lugovskovp/TrafficLight13/README.txt

docs
	ATmega328 datasheet.pdf
	attinu13piout.jpg
	ATtiny13A datasheet.pdf
	AVR4013 — PicoPower basics.pdf
	AVR4027 - Tips and Tricks to Optimize Your C Code.pdf
	Button state machine.vsd
	led colors and voltages.jpg
	power.xlsx

gcc
	0_MAKE & asm.cmd
	0_MAKE & upload.cmd

pix
	arduino pro mini pinout.png
	attiny13 min setup.png
	Button state machine.jpg
	usbasp pinout.png
	vs scr.png

schematic
	traffic light ver0.dch
	traffic light.dch
	traffic light.dip
	
TrafficLight13
	TrafficLight13.ino
	TrafficLight13.vcxproj
	TrafficLight13.vcxproj.filters
