lugovskovp/TrafficLight13/docs/hypothesis_check.txt

https://habr.com/ru/post/443188/#comment_19872776
Предлагаю эксперимент. В свободное/ближайшее время я в исходник светофора добавлю глобальную переменную. Буду в ней считать что-нибудь, неважно, бесполезное. Количество переключений, или сравнивать с чем то, не суть. Просто новая переменная.
Затем сравню размеры прошивок — где переменная как глобальная, и переменная, та же самая, как локальная. Код выложу на github — чтобы любой мог повторить эксперимент.
Моё мнение — что размеры прошивок будут разными, причем в случае с локальной переменной размер будет меньше.

Вы готовы поддержать противоположную точку зрения, сказать, что по-вашему мнению, размер прошивки не уменьшится?

Всё просто, честно, наглядно.

Журнал эксперимента:

Добавлена бесполезная переменная и её использование в TrafficLight13.ino

1. Глобально
uint16_t useless_var __attribute__ ((section (".noinit")));
int main() {

-O0
Program:    2192 bytes (214.1% Full)
Data:         10 bytes (15.6% Full)

-Os
Program:    1060 bytes (103.5% Full)
Data:         10 bytes (15.6% Full)

2. локально
int main() {
	uint16_t useless_var;
	
-O0
Program:    2146 bytes (209.6% Full)
Data:          8 bytes (12.5% Full)
	
-Os
Program:     982 bytes (95.9% Full)
Data:          8 bytes (12.5% Full)

3. Расчеты и выводы
-O0 разница g-l 2192 - 2146 = 46
-Os разница g-l 1060 - 982 = 78
