lugovskovp/TrafficLight13/pix/Button state machine.jpg

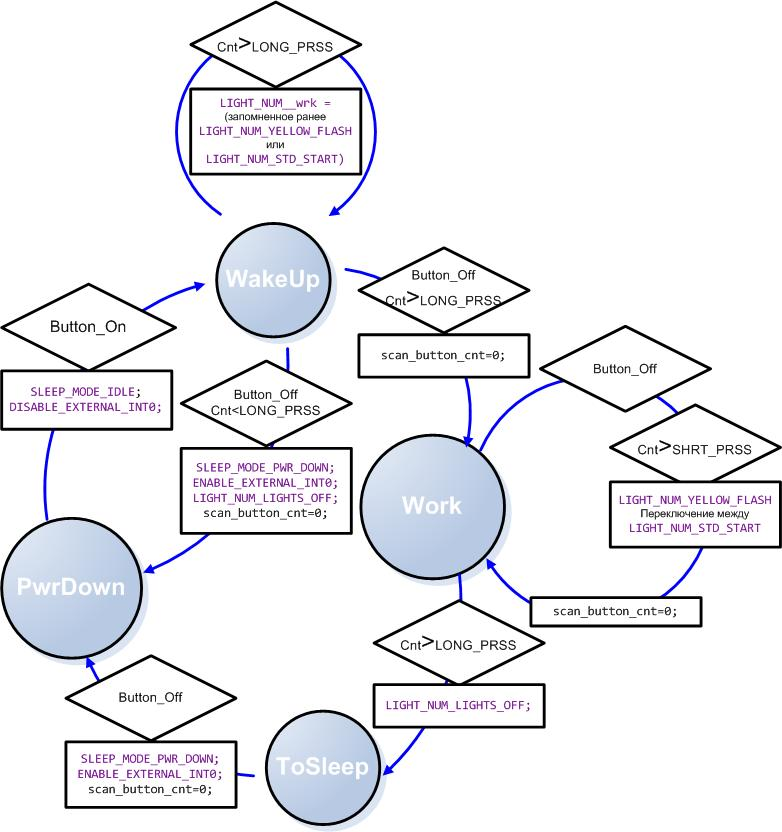
pix/Button state machine.jpg
