lugovskovp/TrafficLight13/pix/led colors and voltages.jpg

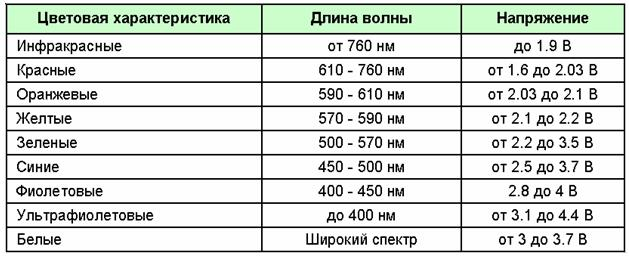
pix/led colors and voltages.jpg
