lugovskovp/TrafficLight13/pix/vs scr.png

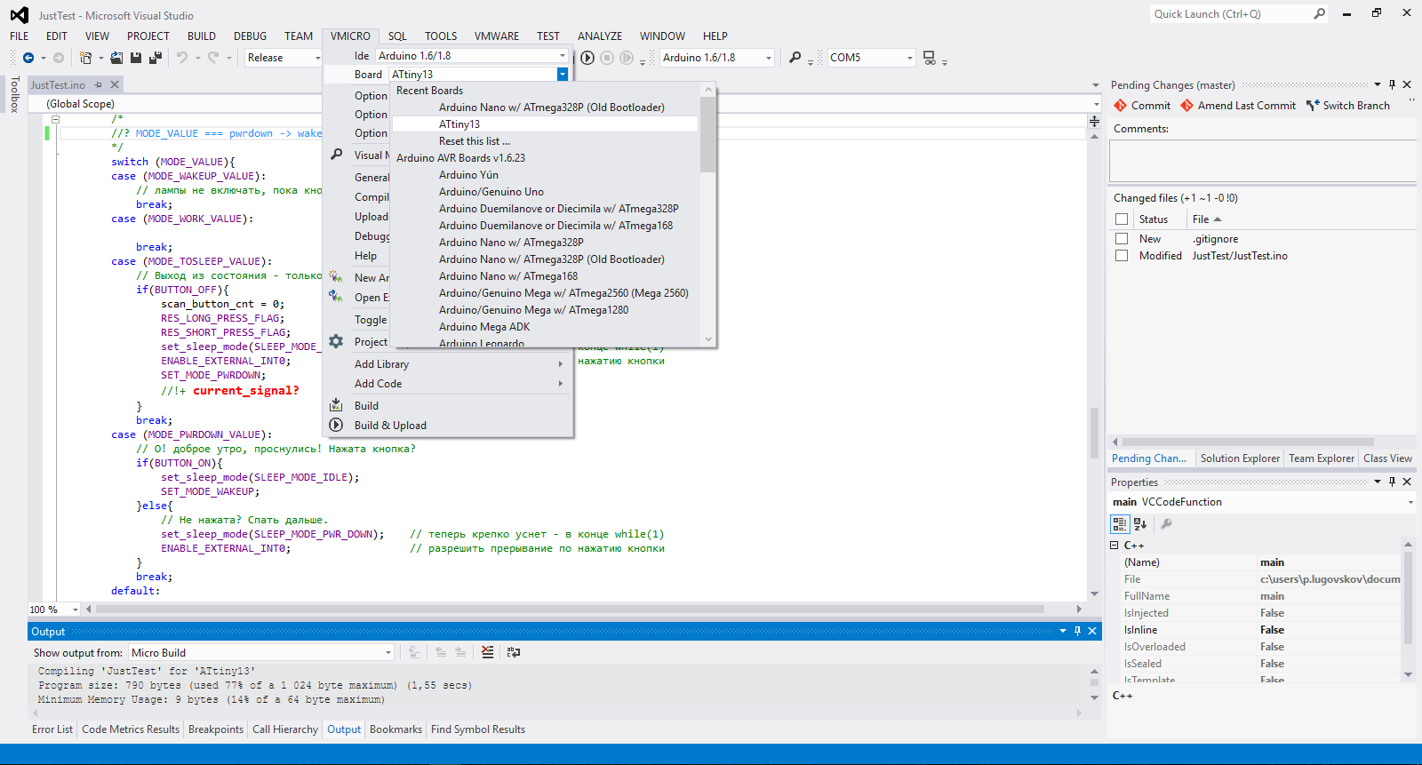
pix/vs scr.png
