lugovskovp/TrafficLight13/(list of files, drawings)

Other design files:
schematic/traffic light ver0.dch
schematic/traffic light ver charlie.dch
schematic/traffic light.dch
schematic/traffic light.dip
