lugovskovp/TrafficLight13/docs/asm/TrafficLight13-Os.asm

./Release/TrafficLight13.elf:     file format elf32-avr


Disassembly of section .text:

00000000 <__vectors>:
   0:	39 c0       	rjmp	.+114    	; 0x74 <__ctors_end>
   2:	5e c0       	rjmp	.+188    	; 0xc0 <__vector_1>
   4:	45 c0       	rjmp	.+138    	; 0x90 <__bad_interrupt>
   6:	45 c0       	rjmp	.+138    	; 0x92 <__vector_3>
   8:	43 c0       	rjmp	.+134    	; 0x90 <__bad_interrupt>
   a:	42 c0       	rjmp	.+132    	; 0x90 <__bad_interrupt>
   c:	41 c0       	rjmp	.+130    	; 0x90 <__bad_interrupt>
   e:	40 c0       	rjmp	.+128    	; 0x90 <__bad_interrupt>
  10:	3f c0       	rjmp	.+126    	; 0x90 <__bad_interrupt>
  12:	3e c0       	rjmp	.+124    	; 0x90 <__bad_interrupt>

00000014 <__trampolines_end>:
  14:	18 08       	sbc	r1, r8
  16:	00 00       	nop
  18:	00 00       	nop
  1a:	b9 00       	.word	0x00b9	; ????
  1c:	08 08       	sbc	r0, r8
  1e:	18 08       	sbc	r1, r8
  20:	09 00       	.word	0x0009	; ????
  22:	6f 00       	.word	0x006f	; ????
  24:	09 09       	sbc	r16, r9
  26:	00 00       	nop
  28:	00 00       	nop
  2a:	25 00       	.word	0x0025	; ????
  2c:	0d 0d       	add	r16, r13
  2e:	00 00       	nop
  30:	00 00       	nop
  32:	4a 00       	.word	0x004a	; ????
  34:	18 10       	cpse	r1, r8
  36:	00 00       	nop
  38:	00 00       	nop
  3a:	03 01       	movw	r0, r6
  3c:	18 10       	cpse	r1, r8
  3e:	08 00       	.word	0x0008	; ????
  40:	09 00       	.word	0x0009	; ????
  42:	6f 00       	.word	0x006f	; ????
  44:	0c 04       	cpc	r0, r12
  46:	00 00       	nop
  48:	00 00       	nop
  4a:	25 00       	.word	0x0025	; ????
  4c:	0d 05       	cpc	r16, r13
  4e:	00 00       	nop
  50:	00 00       	nop
  52:	4a 00       	.word	0x004a	; ????
  54:	05 05       	cpc	r16, r5
  56:	05 00       	.word	0x0005	; ????
  58:	25 00       	.word	0x0025	; ????
	...
  62:	00 00       	nop
  64:	1c 0c       	add	r1, r12
  66:	19 11       	cpse	r17, r9
  68:	01 00       	.word	0x0001	; ????
  6a:	25 00       	.word	0x0025	; ????
  6c:	14 04       	cpc	r1, r4
  6e:	11 11       	cpse	r17, r1
  70:	01 00       	.word	0x0001	; ????
	...

00000074 <__ctors_end>:
  74:	11 24       	eor	r1, r1
  76:	1f be       	out	0x3f, r1	; 63
  78:	cf e9       	ldi	r28, 0x9F	; 159
  7a:	cd bf       	out	0x3d, r28	; 61

0000007c <__do_clear_bss>:
  7c:	20 e0       	ldi	r18, 0x00	; 0
  7e:	a0 e6       	ldi	r26, 0x60	; 96
  80:	b0 e0       	ldi	r27, 0x00	; 0
  82:	01 c0       	rjmp	.+2      	; 0x86 <.do_clear_bss_start>

00000084 <.do_clear_bss_loop>:
  84:	1d 92       	st	X+, r1

00000086 <.do_clear_bss_start>:
  86:	a8 36       	cpi	r26, 0x68	; 104
  88:	b2 07       	cpc	r27, r18
  8a:	e1 f7       	brne	.-8      	; 0x84 <.do_clear_bss_loop>
  8c:	8d d0       	rcall	.+282    	; 0x1a8 <main>
  8e:	8b c1       	rjmp	.+790    	; 0x3a6 <_exit>

00000090 <__bad_interrupt>:
  90:	b7 cf       	rjmp	.-146    	; 0x0 <__vectors>

00000092 <__vector_3>:
  92:	1f 92       	push	r1
  94:	0f 92       	push	r0
  96:	0f b6       	in	r0, 0x3f	; 63
  98:	0f 92       	push	r0
  9a:	11 24       	eor	r1, r1
  9c:	8f 93       	push	r24
  9e:	9f 93       	push	r25
  a0:	80 91 66 00 	lds	r24, 0x0066	; 0x800066 <globalTimer>
  a4:	90 91 67 00 	lds	r25, 0x0067	; 0x800067 <globalTimer+0x1>
  a8:	01 96       	adiw	r24, 0x01	; 1
  aa:	90 93 67 00 	sts	0x0067, r25	; 0x800067 <globalTimer+0x1>
  ae:	80 93 66 00 	sts	0x0066, r24	; 0x800066 <globalTimer>
  b2:	9f 91       	pop	r25
  b4:	8f 91       	pop	r24
  b6:	0f 90       	pop	r0
  b8:	0f be       	out	0x3f, r0	; 63
  ba:	0f 90       	pop	r0
  bc:	1f 90       	pop	r1
  be:	18 95       	reti

000000c0 <__vector_1>:
  c0:	1f 92       	push	r1
  c2:	0f 92       	push	r0
  c4:	0f b6       	in	r0, 0x3f	; 63
  c6:	0f 92       	push	r0
  c8:	11 24       	eor	r1, r1
  ca:	8f 93       	push	r24
  cc:	8b b7       	in	r24, 0x3b	; 59
  ce:	8f 7b       	andi	r24, 0xBF	; 191
  d0:	8b bf       	out	0x3b, r24	; 59
  d2:	8a b7       	in	r24, 0x3a	; 58
  d4:	8f 7b       	andi	r24, 0xBF	; 191
  d6:	8a bf       	out	0x3a, r24	; 58
  d8:	80 91 60 00 	lds	r24, 0x0060	; 0x800060 <_edata>
  dc:	10 92 67 00 	sts	0x0067, r1	; 0x800067 <globalTimer+0x1>
  e0:	10 92 66 00 	sts	0x0066, r1	; 0x800066 <globalTimer>
  e4:	10 92 65 00 	sts	0x0065, r1	; 0x800065 <scan_button_cnt>
  e8:	8f 73       	andi	r24, 0x3F	; 63
  ea:	83 60       	ori	r24, 0x03	; 3
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
 36c:	8b b7       	in	r24, 0x3b	; 59
 36e:	80 64       	ori	r24, 0x40	; 64
 370:	8b bf       	out	0x3b, r24	; 59
 372:	8a b7       	in	r24, 0x3a	; 58
 374:	8f 7b       	andi	r24, 0xBF	; 191
 376:	8a bf       	out	0x3a, r24	; 58
 378:	c9 e0       	ldi	r28, 0x09	; 9
 37a:	80 91 60 00 	lds	r24, 0x0060	; 0x800060 <_edata>
 37e:	82 ff       	sbrs	r24, 2
 380:	0a c0       	rjmp	.+20     	; 0x396 <main+0x1ee>
 382:	8b 7f       	andi	r24, 0xFB	; 251
 384:	80 62       	ori	r24, 0x20	; 32
 386:	80 93 60 00 	sts	0x0060, r24	; 0x800060 <_edata>
 38a:	61 e0       	ldi	r22, 0x01	; 1
 38c:	8c 2f       	mov	r24, r28
 38e:	b6 de       	rcall	.-660    	; 0xfc <_Z8setPortshb>
 390:	61 e0       	ldi	r22, 0x01	; 1
 392:	8c 2f       	mov	r24, r28
 394:	d6 de       	rcall	.-596    	; 0x142 <_Z10setPeriodshb>
 396:	88 95       	sleep
 398:	22 cf       	rjmp	.-444    	; 0x1de <main+0x36>
 39a:	cf 5f       	subi	r28, 0xFF	; 255
 39c:	c7 70       	andi	r28, 0x07	; 7
 39e:	84 60       	ori	r24, 0x04	; 4
 3a0:	80 93 60 00 	sts	0x0060, r24	; 0x800060 <_edata>
 3a4:	81 cf       	rjmp	.-254    	; 0x2a8 <main+0x100>

000003a6 <_exit>:
 3a6:	f8 94       	cli

000003a8 <__stop_program>:
 3a8:	ff cf       	rjmp	.-2      	; 0x3a8 <__stop_program>
