lugovskovp/TrafficLight13/docs/asm/TrafficLight13-O0.asm

./Release/TrafficLight13.elf:     file format elf32-avr


Disassembly of section .text:

00000000 <__vectors>:
   0:	39 c0       	rjmp	.+114    	; 0x74 <__ctors_end>
   2:	67 c0       	rjmp	.+206    	; 0xd2 <__vector_1>
   4:	45 c0       	rjmp	.+138    	; 0x90 <__bad_interrupt>
   6:	45 c0       	rjmp	.+138    	; 0x92 <__vector_3>
   8:	43 c0       	rjmp	.+134    	; 0x90 <__bad_interrupt>
   a:	42 c0       	rjmp	.+132    	; 0x90 <__bad_interrupt>
   c:	41 c0       	rjmp	.+130    	; 0x90 <__bad_interrupt>
   e:	40 c0       	rjmp	.+128    	; 0x90 <__bad_interrupt>
  10:	3f c0       	rjmp	.+126    	; 0x90 <__bad_interrupt>
  12:	3e c0       	rjmp	.+124    	; 0x90 <__bad_interrupt>

00000014 <__trampolines_end>:
  14:	18 08       	sbc	r1, r8
  16:	00 00       	nop
  18:	00 00       	nop
  1a:	b9 00       	.word	0x00b9	; ????
  1c:	08 08       	sbc	r0, r8
  1e:	18 08       	sbc	r1, r8
  20:	09 00       	.word	0x0009	; ????
  22:	6f 00       	.word	0x006f	; ????
  24:	09 09       	sbc	r16, r9
  26:	00 00       	nop
  28:	00 00       	nop
  2a:	25 00       	.word	0x0025	; ????
  2c:	0d 0d       	add	r16, r13
  2e:	00 00       	nop
  30:	00 00       	nop
  32:	4a 00       	.word	0x004a	; ????
  34:	18 10       	cpse	r1, r8
  36:	00 00       	nop
  38:	00 00       	nop
  3a:	03 01       	movw	r0, r6
  3c:	18 10       	cpse	r1, r8
  3e:	08 00       	.word	0x0008	; ????
  40:	09 00       	.word	0x0009	; ????
  42:	6f 00       	.word	0x006f	; ????
  44:	0c 04       	cpc	r0, r12
  46:	00 00       	nop
  48:	00 00       	nop
  4a:	25 00       	.word	0x0025	; ????
  4c:	0d 05       	cpc	r16, r13
  4e:	00 00       	nop
  50:	00 00       	nop
  52:	4a 00       	.word	0x004a	; ????
  54:	05 05       	cpc	r16, r5
  56:	05 00       	.word	0x0005	; ????
  58:	25 00       	.word	0x0025	; ????
	...
  62:	00 00       	nop
  64:	1c 0c       	add	r1, r12
  66:	19 11       	cpse	r17, r9
  68:	01 00       	.word	0x0001	; ????
  6a:	25 00       	.word	0x0025	; ????
  6c:	14 04       	cpc	r1, r4
  6e:	11 11       	cpse	r17, r1
  70:	01 00       	.word	0x0001	; ????
	...

00000074 <__ctors_end>:
  74:	11 24       	eor	r1, r1
  76:	1f be       	out	0x3f, r1	; 63
  78:	cf e9       	ldi	r28, 0x9F	; 159
  7a:	cd bf       	out	0x3d, r28	; 61

0000007c <__do_clear_bss>:
  7c:	20 e0       	ldi	r18, 0x00	; 0
  7e:	a0 e6       	ldi	r26, 0x60	; 96
  80:	b0 e0       	ldi	r27, 0x00	; 0
  82:	01 c0       	rjmp	.+2      	; 0x86 <.do_clear_bss_start>

00000084 <.do_clear_bss_loop>:
  84:	1d 92       	st	X+, r1

00000086 <.do_clear_bss_start>:
  86:	a8 36       	cpi	r26, 0x68	; 104
  88:	b2 07       	cpc	r27, r18
  8a:	e1 f7       	brne	.-8      	; 0x84 <.do_clear_bss_loop>
  8c:	6d d0       	rcall	.+218    	; 0x168 <main>
  8e:	b1 c3       	rjmp	.+1890   	; 0x7f2 <_exit>

00000090 <__bad_interrupt>:
  90:	b7 cf       	rjmp	.-146    	; 0x0 <__vectors>

00000092 <__vector_3>:
  92:	1f 92       	push	r1
  94:	0f 92       	push	r0
  96:	00 90 5f 00 	lds	r0, 0x005F	; 0x80005f <__EEPROM_REGION_LENGTH__+0x7f005f>
  9a:	0f 92       	push	r0
  9c:	11 24       	eor	r1, r1
  9e:	8f 93       	push	r24
  a0:	9f 93       	push	r25
  a2:	cf 93       	push	r28
  a4:	df 93       	push	r29
  a6:	cd b7       	in	r28, 0x3d	; 61
  a8:	dd 27       	eor	r29, r29
  aa:	80 91 60 00 	lds	r24, 0x0060	; 0x800060 <_edata>
  ae:	90 91 61 00 	lds	r25, 0x0061	; 0x800061 <_edata+0x1>
  b2:	01 96       	adiw	r24, 0x01	; 1
  b4:	90 93 61 00 	sts	0x0061, r25	; 0x800061 <_edata+0x1>
  b8:	80 93 60 00 	sts	0x0060, r24	; 0x800060 <_edata>
  bc:	00 00       	nop
  be:	df 91       	pop	r29
  c0:	cf 91       	pop	r28
  c2:	9f 91       	pop	r25
  c4:	8f 91       	pop	r24
  c6:	0f 90       	pop	r0
  c8:	00 92 5f 00 	sts	0x005F, r0	; 0x80005f <__EEPROM_REGION_LENGTH__+0x7f005f>
  cc:	0f 90       	pop	r0
  ce:	1f 90       	pop	r1
  d0:	18 95       	reti

000000d2 <__vector_1>:
  d2:	1f 92       	push	r1
  d4:	0f 92       	push	r0
  d6:	00 90 5f 00 	lds	r0, 0x005F	; 0x80005f <__EEPROM_REGION_LENGTH__+0x7f005f>
  da:	0f 92       	push	r0
  dc:	11 24       	eor	r1, r1
  de:	2f 93       	push	r18
  e0:	3f 93       	push	r19
  e2:	8f 93       	push	r24
  e4:	9f 93       	push	r25
  e6:	ef 93       	push	r30
  e8:	ff 93       	push	r31
  ea:	cf 93       	push	r28
  ec:	df 93       	push	r29
  ee:	cd b7       	in	r28, 0x3d	; 61
  f0:	dd 27       	eor	r29, r29
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
 7e6:	fc 01       	movw	r30, r24
 7e8:	20 83       	st	Z, r18
 7ea:	00 00       	nop
 7ec:	df 91       	pop	r29
 7ee:	cf 91       	pop	r28
 7f0:	08 95       	ret

000007f2 <_exit>:
 7f2:	f8 94       	cli

000007f4 <__stop_program>:
 7f4:	ff cf       	rjmp	.-2      	; 0x7f4 <__stop_program>
