lugovskovp/TrafficLight13/(commit log)

2019-03-05 Скелет ардуино программы TrafficLight13\TrafficLight13.ino
    [power.xlsx, traffic light ver0.dch, traffic light.dch, traffic light.dip]
2019-03-05 Экономия 100 байт от main() //Program size: 128 bytes (used 13% of a 1 024 byte maximum) (0,86 secs) //Minimum Memory Usage: 2 bytes (3% of a 64 byte maximum)
    а было
    //Program size: 164 bytes (used 16% of a 1 024 byte maximum) (0,57 secs)
    //Minimum Memory Usage: 5 bytes (8% of a 64 byte maximum)
2019-03-05 Таймер и сон: размер прошивки 128 байт
2019-03-05 Светофор есть! Пока без переключения режимов, но все варианты сигнализации работают + const lightSignalization traffic_signals[] PROGMEM=
    //Program size: 610 bytes (used 60% of a 1 024 byte maximum) (0,58 secs)
    //Minimum Memory Usage: 7 bytes (11% of a 64 byte maximum)
2019-03-05 Добавлена логика кнопки и уход в power down mode.
    //Program size: 976 bytes (used 95% of a 1 024 byte maximum) (1,59 secs)
    //Minimum Memory Usage: 8 bytes (13% of a 64 byte maximum)
2019-03-08 Schematic screenshot
2019-03-08 Adding schematic picture in README.md
2019-03-10 If it would be Charlieplexing on 4 pin.
    [traffic light ver charlie.dch]
2019-03-10 Bipolar PNP transistor blocking-generator for white LED with 1.5 AA battery
    [traffic light ver0.dch]
2019-03-10 Actual schematic file
    [traffic light.dch]
2019-03-10 Actual PCB Layout
    [traffic light.dip]
2019-03-10 minor bug: one of four green LED was named as RED.
    [traffic light.dch]
2019-03-14 global-local array + printf
